sangameshwarekale-arch/ReversePolarityProtection4MOSFET/reports/conduction-calculations.csv

case | front_count | downstream_count | front_current_each_A | downstream_current_each_A | total_R_milliohm | drop_mV | MOSFET_loss_W | front_loss_each_W | downstream_loss_each_W | conditions
25 C specified resistance | 2 | 4 | 22.5 | 11.25 | 1.2 | 53.99999999999999 | 2.4299999999999997 | 0.6074999999999999 | 0.30374999999999996 | Front at 25 C / 10 V gate; downstream at 25 C / 4.5 V gate
25 C specified resistance | 2 | 2 | 22.5 | 22.5 | 1.8 | 81.0 | 3.645 | 0.6074999999999999 | 1.2149999999999999 | Front at 25 C / 10 V gate; downstream at 25 C / 4.5 V gate
25 C specified resistance | 1 | 3 | 45.0 | 15.0 | 2.0 | 90.0 | 4.05 | 2.4299999999999997 | 0.5399999999999999 | Front at 25 C / 10 V gate; downstream at 25 C / 4.5 V gate
25 C specified resistance | 3 | 1 | 15.0 | 45.0 | 2.7999999999999994 | 125.99999999999997 | 5.669999999999999 | 0.26999999999999996 | 4.859999999999999 | Front at 25 C / 10 V gate; downstream at 25 C / 4.5 V gate
105 C / 150 C benchmark | 2 | 4 | 22.5 | 11.25 | 2.3249999999999997 | 104.625 | 4.708125 | 1.11375 | 0.62015625 | Front at 105 C / 10 V gate; downstream at 150 C / 4.5 V gate
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
