sangameshwarekale-arch/ReversePolarityProtection4MOSFET/calculations/placement/candidate-all-top.png

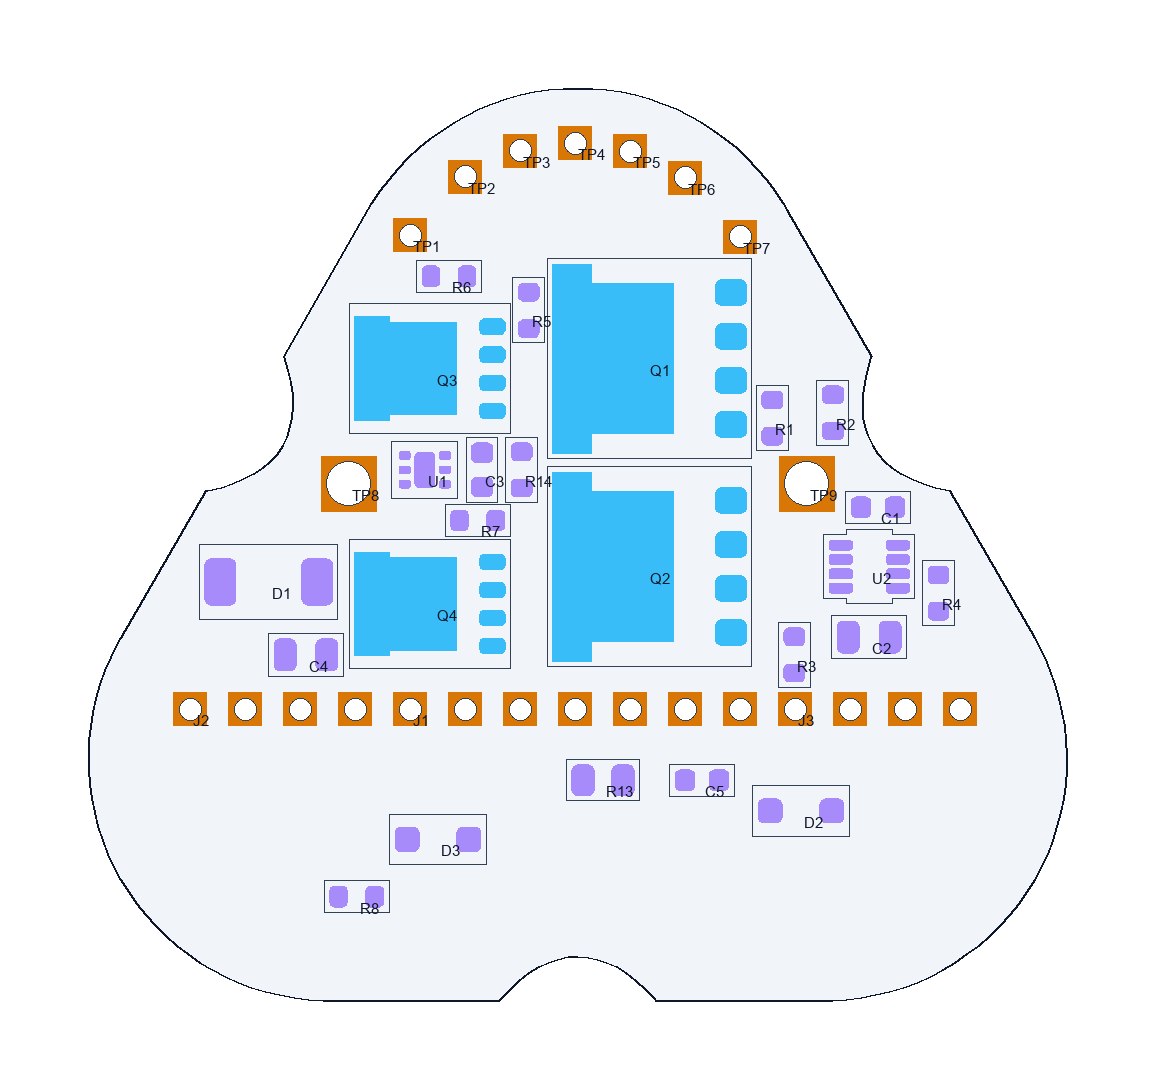
calculations/placement/candidate-all-top.png
