sangameshwarekale-arch/ReversePolarityProtection4MOSFET/redesign45A/routed/images/front.png

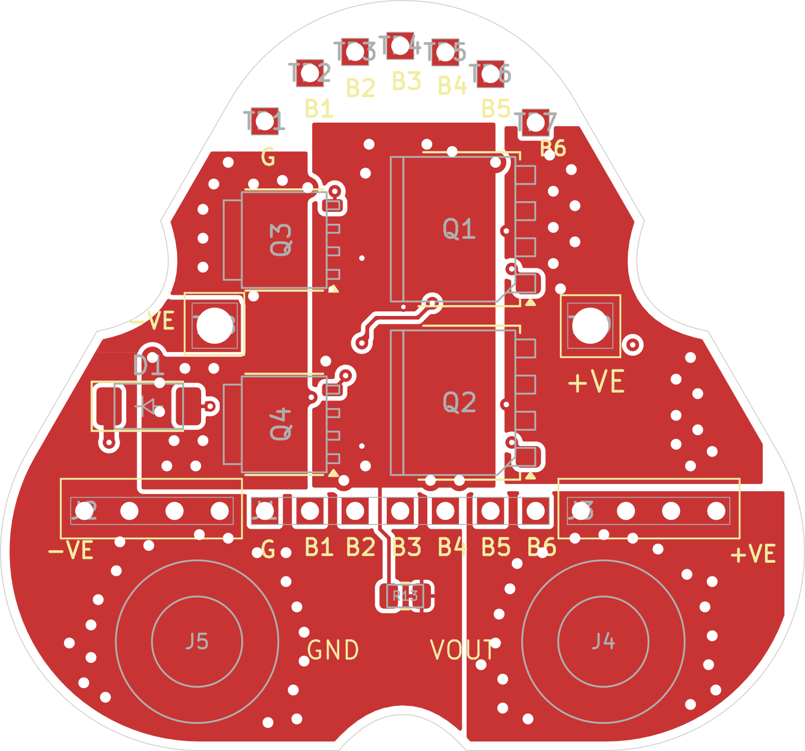
redesign45A/routed/images/front.png
