sangameshwarekale-arch/ReversePolarityProtection4MOSFET/redesign45A/routed/images/inner1.png

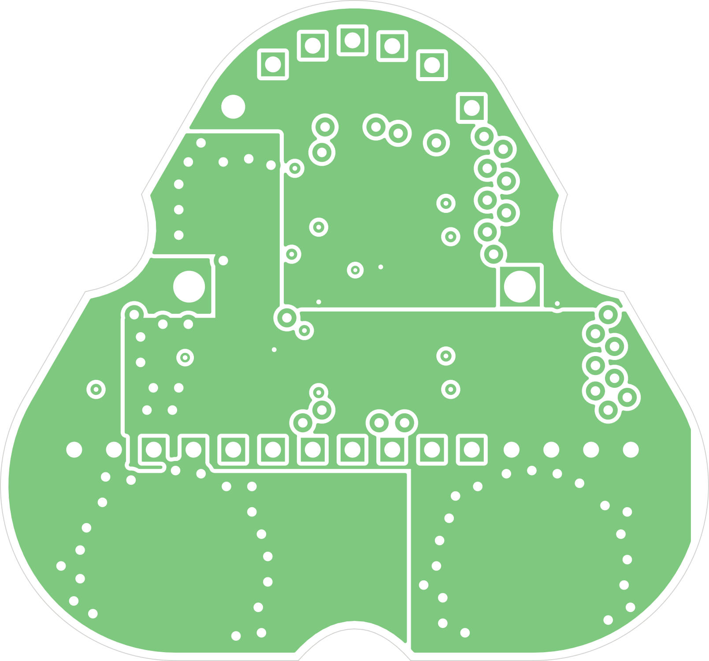
redesign45A/routed/images/inner1.png
