sangameshwarekale-arch/ReversePolarityProtection4MOSFET/redesign45A/routed/images/original-front.png

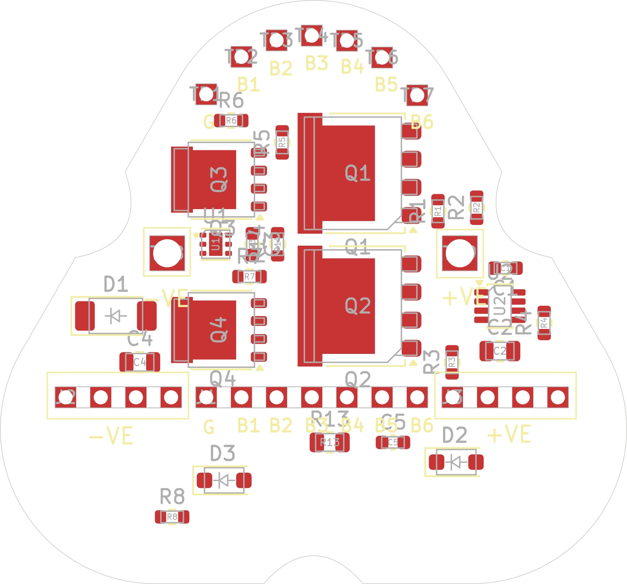
redesign45A/routed/images/original-front.png
