sangameshwarekale-arch/ReversePolarityProtection4MOSFET/redesign45A/routed/images/rear.png

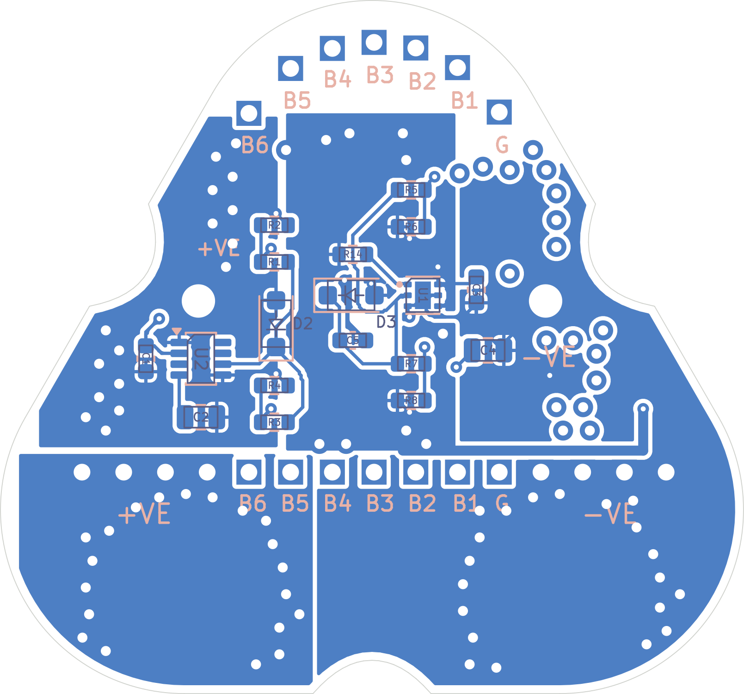
redesign45A/routed/images/rear.png
