sangameshwarekale-arch/ReversePolarityProtection4MOSFET/redesign45A/routed/images/routed-comparison.png

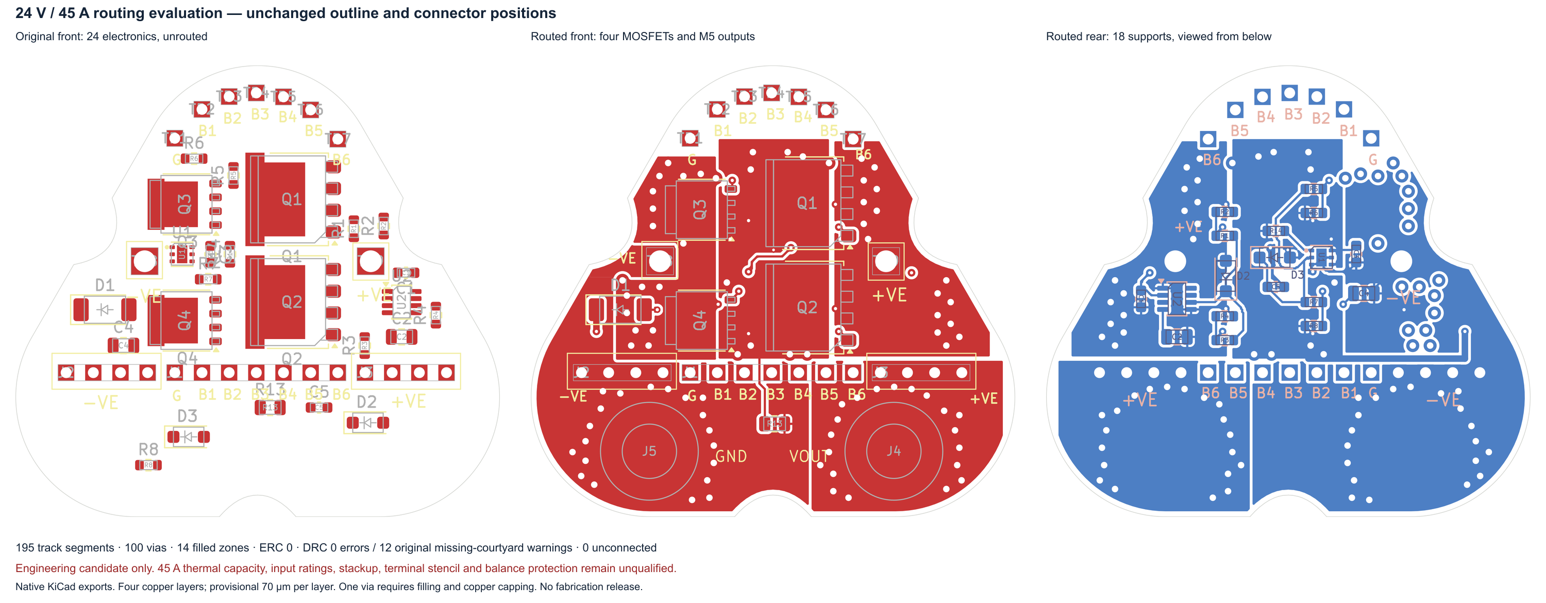
redesign45A/routed/images/routed-comparison.png
