sangameshwarekale-arch/ReversePolarityProtection4MOSFET/redesign45A/routed/images/schematic.png

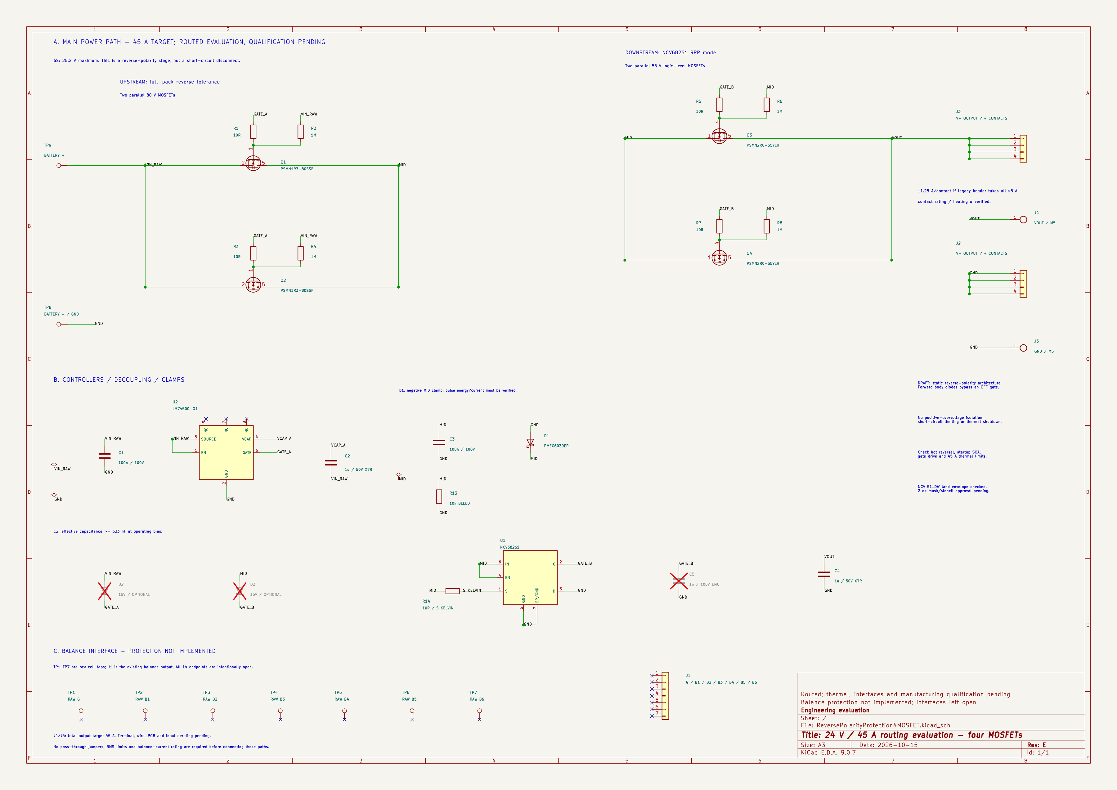
redesign45A/routed/images/schematic.png
