sangameshwarekale-arch/ReversePolarityProtection4MOSFET/BOM.csv

Reference | Quantity | Value | Manufacturer | Manufacturer part number | Footprint | Population | Datasheet | Assembly / qualification note
Q1 | 1 | PSMN1R3-80SSF | Nexperia | PSMN1R3-80SSFJ | Protection:LFPAK88 | Fit | https://assets.nexperia.com/documents/data-sheet/PSMN1R3-80SSF.pdf | Existing selected component; actual operating/thermal conditions require qualification.
R1 | 1 | 10R | Yageo | RC0603FR-0710RL | Resistor_SMD:R_0603_1608Metric | Fit | ~ | Existing selected component; actual operating/thermal conditions require qualification.
R2 | 1 | 1M | Yageo | RC0603FR-071ML | Resistor_SMD:R_0603_1608Metric | Fit | ~ | Existing selected component; actual operating/thermal conditions require qualification.
Q2 | 1 | PSMN1R3-80SSF | Nexperia | PSMN1R3-80SSFJ | Protection:LFPAK88 | Fit | https://assets.nexperia.com/documents/data-sheet/PSMN1R3-80SSF.pdf | Existing selected component; actual operating/thermal conditions require qualification.
R3 | 1 | 10R | Yageo | RC0603FR-0710RL | Resistor_SMD:R_0603_1608Metric | Fit | ~ | Existing selected component; actual operating/thermal conditions require qualification.
R4 | 1 | 1M | Yageo | RC0603FR-071ML | Resistor_SMD:R_0603_1608Metric | Fit | ~ | Existing selected component; actual operating/thermal conditions require qualification.
Q3 | 1 | PSMN2R0-55YLH | Nexperia | PSMN2R0-55YLHX | Protection:LFPAK56E | Fit | https://assets.nexperia.com/documents/data-sheet/PSMN2R0-55YLH.pdf | Existing selected component; actual operating/thermal conditions require qualification.
R5 | 1 | 10R | Yageo | RC0603FR-0710RL | Resistor_SMD:R_0603_1608Metric | Fit | ~ | Existing selected component; actual operating/thermal conditions require qualification.
R6 | 1 | 1M | Yageo | RC0603FR-071ML | Resistor_SMD:R_0603_1608Metric | Fit | ~ | Existing selected component; actual operating/thermal conditions require qualification.
Q4 | 1 | PSMN2R0-55YLH | Nexperia | PSMN2R0-55YLHX | Protection:LFPAK56E | Fit | https://assets.nexperia.com/documents/data-sheet/PSMN2R0-55YLH.pdf | Existing selected component; actual operating/thermal conditions require qualification.
R7 | 1 | 10R | Yageo | RC0603FR-0710RL | Resistor_SMD:R_0603_1608Metric | Fit | ~ | Existing selected component; actual operating/thermal conditions require qualification.
R8 | 1 | 1M | Yageo | RC0603FR-071ML | Resistor_SMD:R_0603_1608Metric | Fit | ~ | Existing selected component; actual operating/thermal conditions require qualification.
TP9 | 1 | BATTERY + | Unknown original termination | EXISTING TERMINATION - RATING UNKNOWN | OriginalMechanical:WireSolderPad_VPlus_DXF | Fit | ~ | Original model/current rating/body envelope unknown; preserved geometry. Not qualified for45A.
TP8 | 1 | BATTERY - / GND | Unknown original termination | EXISTING TERMINATION - RATING UNKNOWN | OriginalMechanical:WireSolderPad_VMinus_DXF | Fit | ~ | Original model/current rating/body envelope unknown; preserved geometry. Not qualified for45A.
J3 | 1 | V+ OUTPUT / 4 CONTACTS | Unknown original termination | EXISTING CONNECTOR - RATING UNKNOWN | OriginalMechanical:Connector_1x04_P2.50mm_VPlus_DXF | Fit | ~ | Original model/current rating/body envelope unknown; preserved geometry. Not qualified for45A.
J2 | 1 | V- OUTPUT / 4 CONTACTS | Unknown original termination | EXISTING CONNECTOR - RATING UNKNOWN | OriginalMechanical:Connector_1x04_P2.50mm_VMinus_DXF | Fit | ~ | Original model/current rating/body envelope unknown; preserved geometry. Not qualified for45A.
U2 | 1 | LM74500-Q1 | Texas Instruments | LM74500QDDFRQ1 | Protection:TI_DDF8 | Fit | https://www.ti.com/lit/ds/symlink/lm74500-q1.pdf | Existing selected component; actual operating/thermal conditions require qualification.
U1 | 1 | NCV68261 | onsemi | NCV68261MTWAITBG | Protection:NCV68261_WDFNW6 | Fit | https://www.onsemi.com/pdf/datasheet/ncv68261-d.pdf | Existing selected component; actual operating/thermal conditions require qualification.
R14 | 1 | 10R / S KELVIN | Yageo | RC0603FR-0710RL | Resistor_SMD:R_0603_1608Metric | Fit | ~ | Existing selected component; actual operating/thermal conditions require qualification.
C1 | 1 | 100n / 100V | Murata | GRM188R72A104KA35D | Capacitor_SMD:C_0603_1608Metric | Fit | https://search.murata.co.jp/Ceramy/image/img/A01X/G101/ENG/GRM188R72A104KA35-01A.pdf | Existing selected component; actual operating/thermal conditions require qualification.
C2 | 1 | 1u / 50V X7R | Murata | GCM21BR71H105KA03L | Capacitor_SMD:C_0805_2012Metric | Fit | https://search.murata.co.jp/Ceramy/image/img/A01X/G101/ENG/GCM21BR71H105KA03-01A.pdf | Existing selected component; actual operating/thermal conditions require qualification.
C3 | 1 | 100n / 100V | Murata | GRM188R72A104KA35D | Capacitor_SMD:C_0603_1608Metric | Fit | ~ | Existing selected component; actual operating/thermal conditions require qualification.
C4 | 1 | 1u / 50V X7R | Murata | GCM21BR71H105KA03L | Capacitor_SMD:C_0805_2012Metric | Fit | ~ | Existing selected component; actual operating/thermal conditions require qualification.
C5 | 1 | 1n / 100V EMC | Murata | GCM1885C2A102JA16D | Capacitor_SMD:C_0603_1608Metric | DNP | ~ | DNP retained; do not credit as fitted protection. Verify ratings before population.
R13 | 1 | 10k BLEED | Yageo | RC0805FR-0710KL | Resistor_SMD:R_0805_2012Metric | Fit | ~ | Existing selected component; actual operating/thermal conditions require qualification.
D1 | 1 | PMEG6030EP | Nexperia | PMEG6030EP,115 | Protection:SOD128 | Fit | https://assets.nexperia.com/documents/data-sheet/PMEG6030EP.pdf | Existing selected component; actual operating/thermal conditions require qualification.
D2 | 1 | 15V / OPTIONAL | Nexperia | BZT52H-C15,115 | Protection:SOD123F | DNP | https://assets.nexperia.com/documents/data-sheet/BZT52H_SER.pdf | DNP retained; do not credit as fitted protection. Verify ratings before population.
D3 | 1 | 15V / OPTIONAL | Nexperia | BZT52H-C15,115 | Protection:SOD123F | DNP | https://assets.nexperia.com/documents/data-sheet/BZT52H_SER.pdf | DNP retained; do not credit as fitted protection. Verify ratings before population. Adjacent MID tie via X126.9,Y89.0 requires filling and copper capping both sides.
TP1 | 1 | RAW G | Unknown original termination | EXISTING TAP | OriginalMechanical:BatteryTap_G_DXF | Fit | ~ | Original model/current rating/body envelope unknown; preserved geometry. Not qualified for45A.
TP2 | 1 | RAW B1 | Unknown original termination | EXISTING TAP | OriginalMechanical:BatteryTap_B1_DXF | Fit | ~ | Original model/current rating/body envelope unknown; preserved geometry. Not qualified for45A.
TP3 | 1 | RAW B2 | Unknown original termination | EXISTING TAP | OriginalMechanical:BatteryTap_B2_DXF | Fit | ~ | Original model/current rating/body envelope unknown; preserved geometry. Not qualified for45A.
TP4 | 1 | RAW B3 | Unknown original termination | EXISTING TAP | OriginalMechanical:BatteryTap_B3_DXF | Fit | ~ | Original model/current rating/body envelope unknown; preserved geometry. Not qualified for45A.
TP5 | 1 | RAW B4 | Unknown original termination | EXISTING TAP | OriginalMechanical:BatteryTap_B4_DXF | Fit | ~ | Original model/current rating/body envelope unknown; preserved geometry. Not qualified for45A.
TP6 | 1 | RAW B5 | Unknown original termination | EXISTING TAP | OriginalMechanical:BatteryTap_B5_DXF | Fit | ~ | Original model/current rating/body envelope unknown; preserved geometry. Not qualified for45A.
TP7 | 1 | RAW B6 | Unknown original termination | EXISTING TAP | OriginalMechanical:BatteryTap_B6_DXF | Fit | ~ | Original model/current rating/body envelope unknown; preserved geometry. Not qualified for45A.
J1 | 1 | G / B1 / B2 / B3 / B4 / B5 / B6 | Unknown original termination | EXISTING CONNECTOR - RATING UNKNOWN | OriginalMechanical:Header_1x07_P2.50mm_DXF | Fit | ~ | Original model/current rating/body envelope unknown; preserved geometry. Not qualified for45A.
J4 | 1 | VOUT / M5 | Wurth Elektronik | 7466205R | Protection:Wuerth_7466205R_M5_SMT | Candidate fit; thermal/mechanical/stencil qualification pending | https://www.we-online.com/components/products/datasheet/7466205R.pdf | Candidate70A catalogue terminal; total board target45A, actual derating unverified. No paste apertures: stencil hold; lug/hardware/support not selected.
J5 | 1 | GND / M5 | Wurth Elektronik | 7466205R | Protection:Wuerth_7466205R_M5_SMT | Candidate fit; thermal/mechanical/stencil qualification pending | https://www.we-online.com/components/products/datasheet/7466205R.pdf | Candidate70A catalogue terminal; total board target45A, actual derating unverified. No paste apertures: stencil hold; lug/hardware/support not selected.
