sangameshwarekale-arch/ReversePolarityProtection4MOSFET/reports/schematic-preliminary-60A.pdf

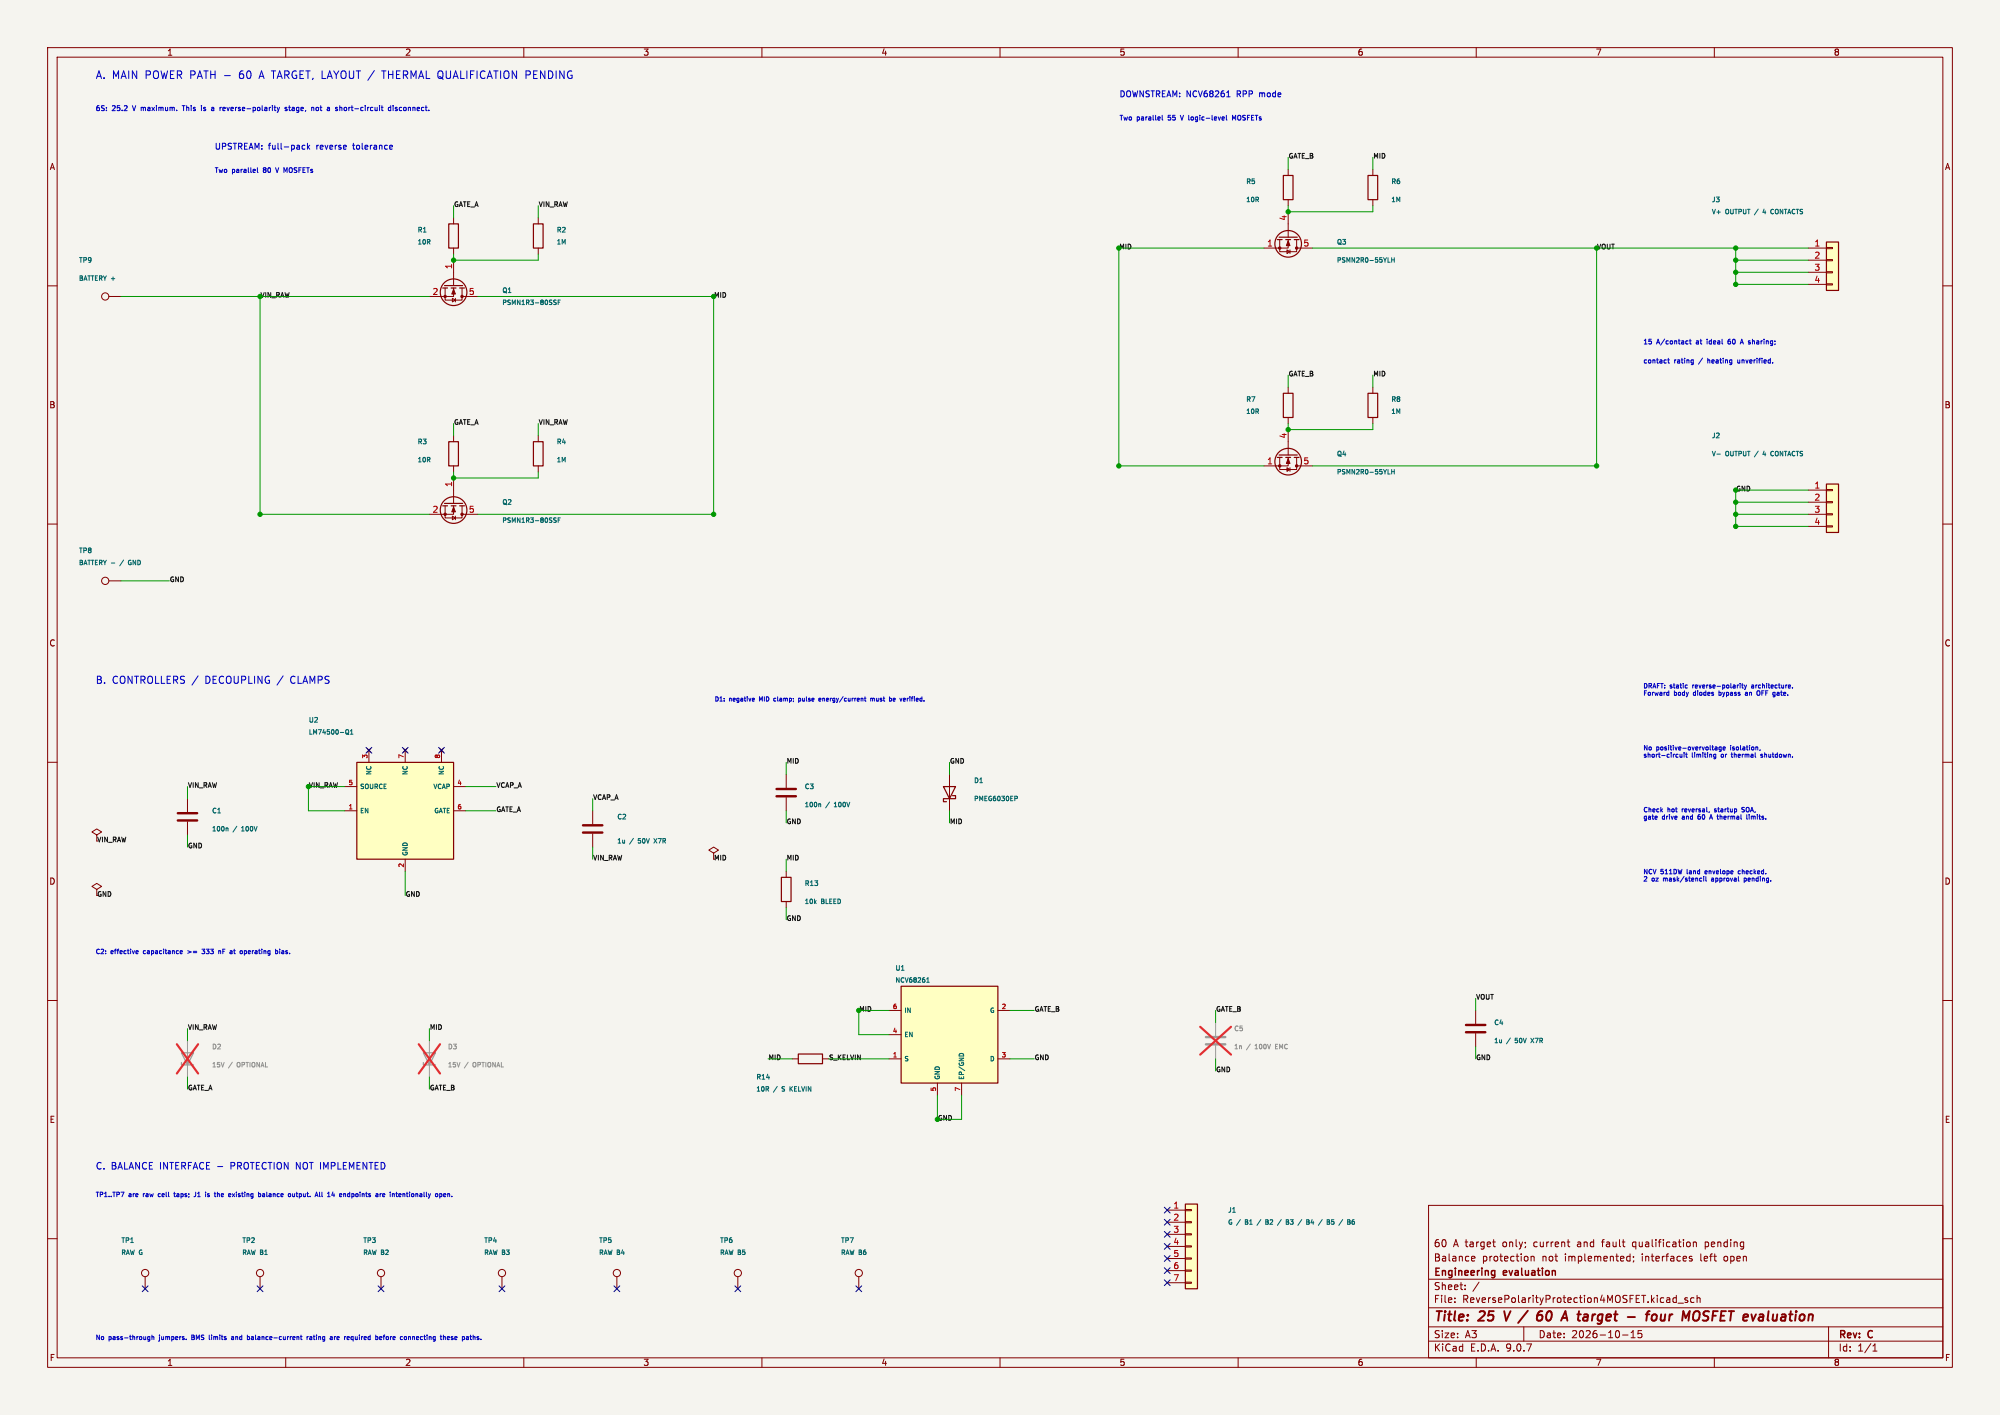
[picture p8: page 1]

A. MAIN POWER PATH - 60 A TARGET, LAYOUT / THERMAL QUALIFICATION PENDING

Id: 1/1 Title: 25 V / 60 A target - four MOSFET evaluation
