sangameshwarekale-arch/ReversePolarityProtection4MOSFET/(list of files, drawings)

Other design files:
reports/schematic-60A-status-update.json
