sangameshwarekale-arch/ReversePolarityProtection4MOSFET/ReversePolarityProtection4MOSFET.kicad_pcb

## KiCad design ReversePolarityProtection4MOSFET.kicad_pcb (2026-10-15)

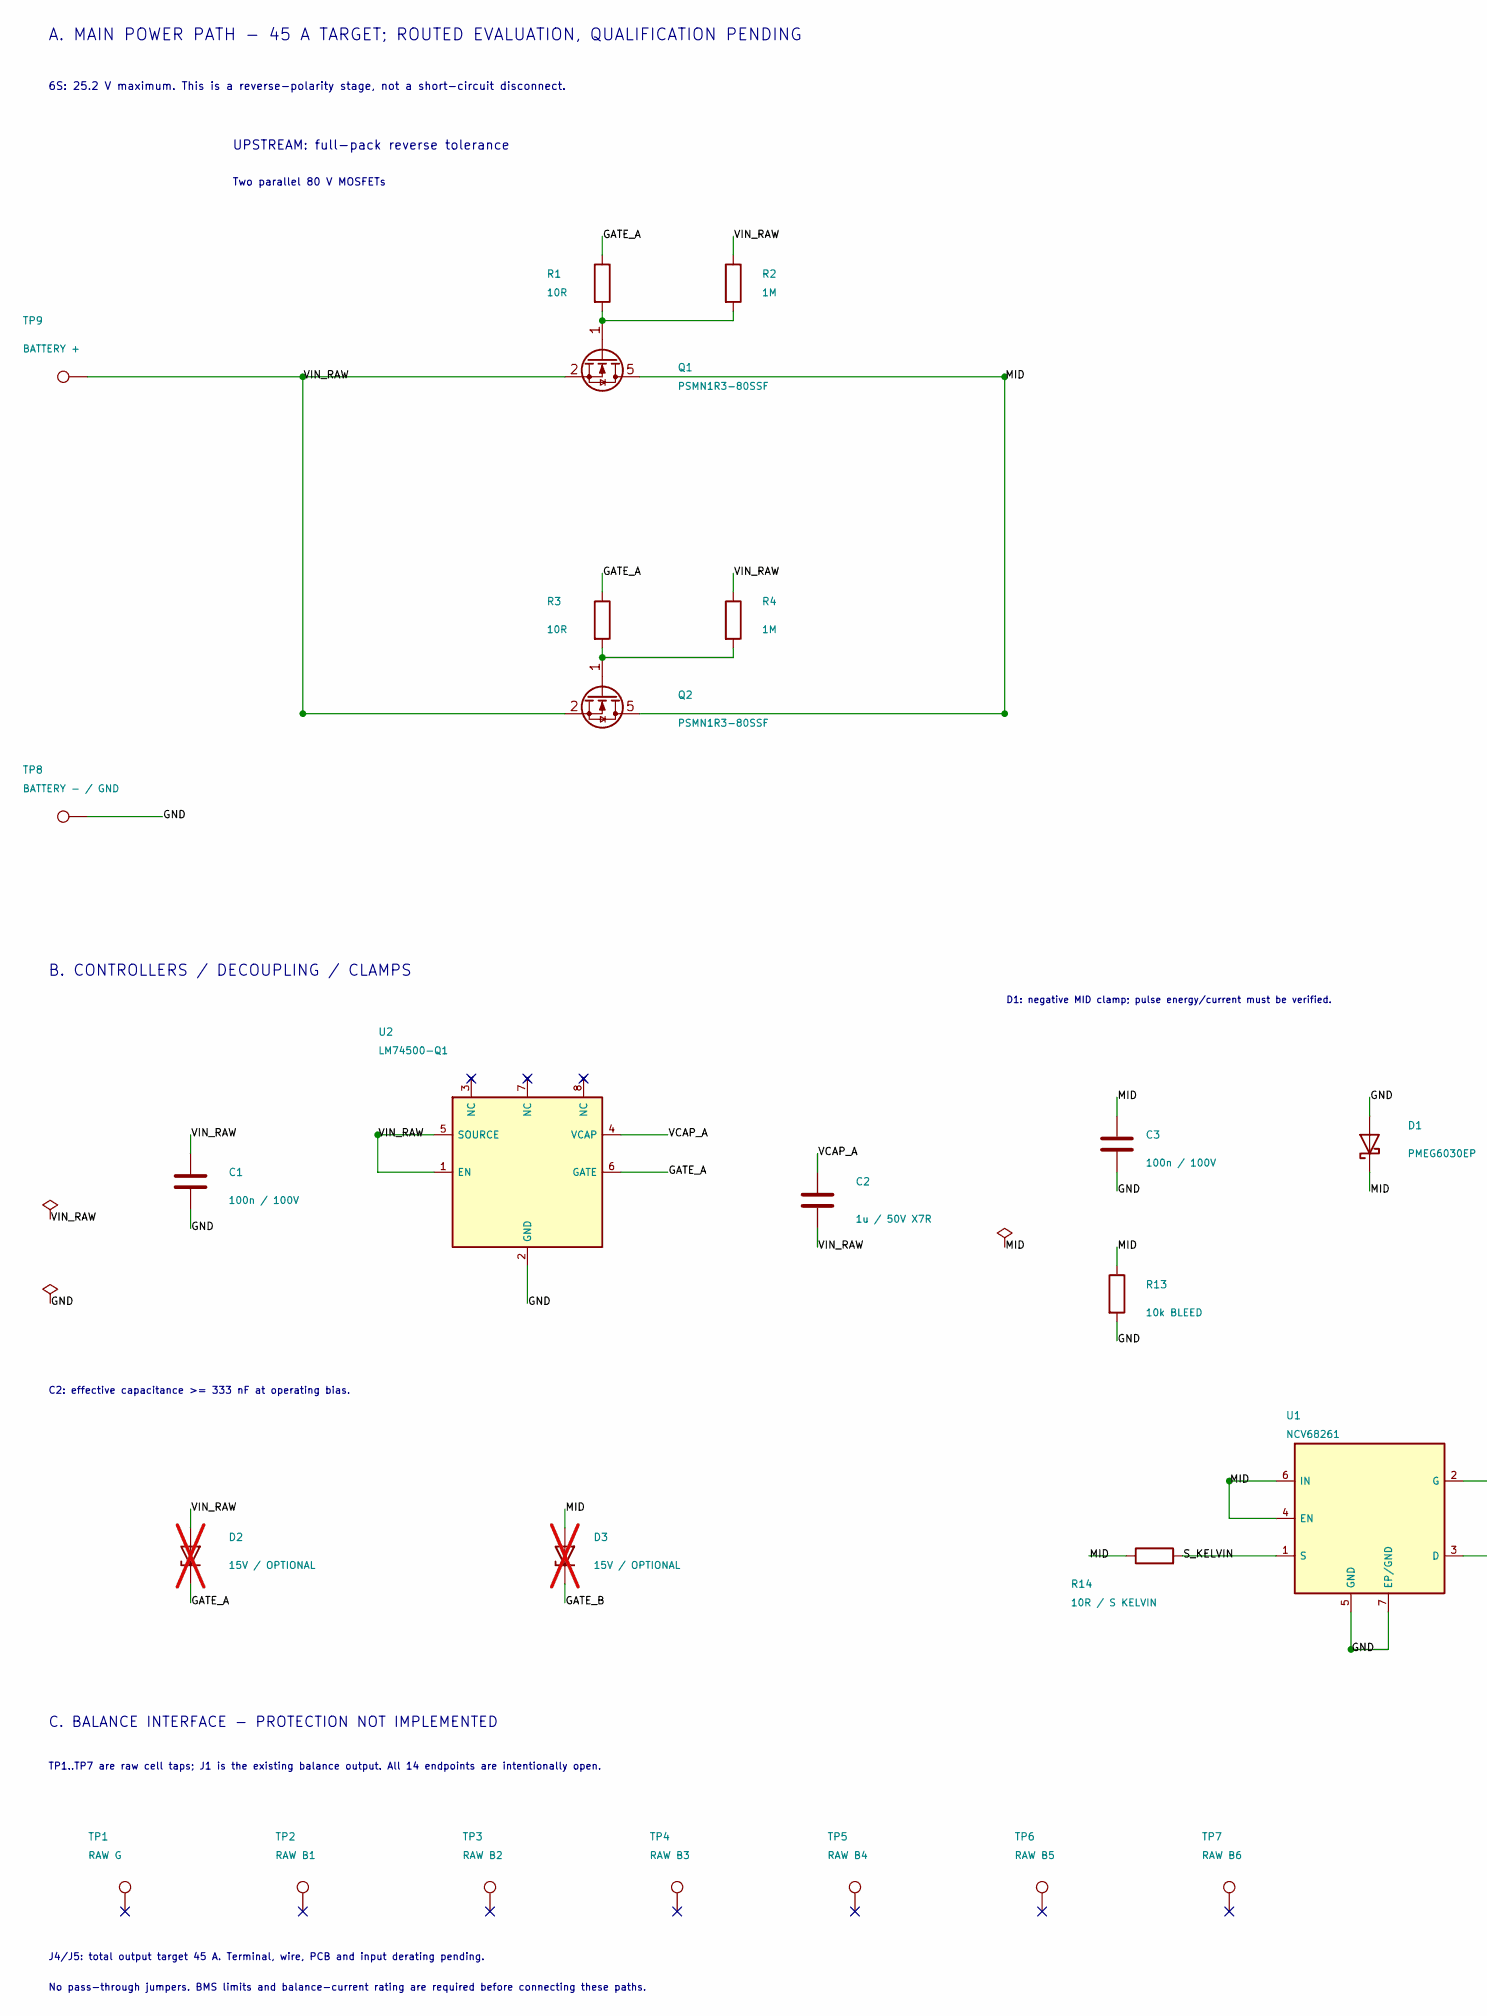
[picture p9: schematic ReversePolarityProtection4MOSFET.kicad_sch, 24 V / 45 A routing evaluation - four MOSFETs, part in row 1, column 1]

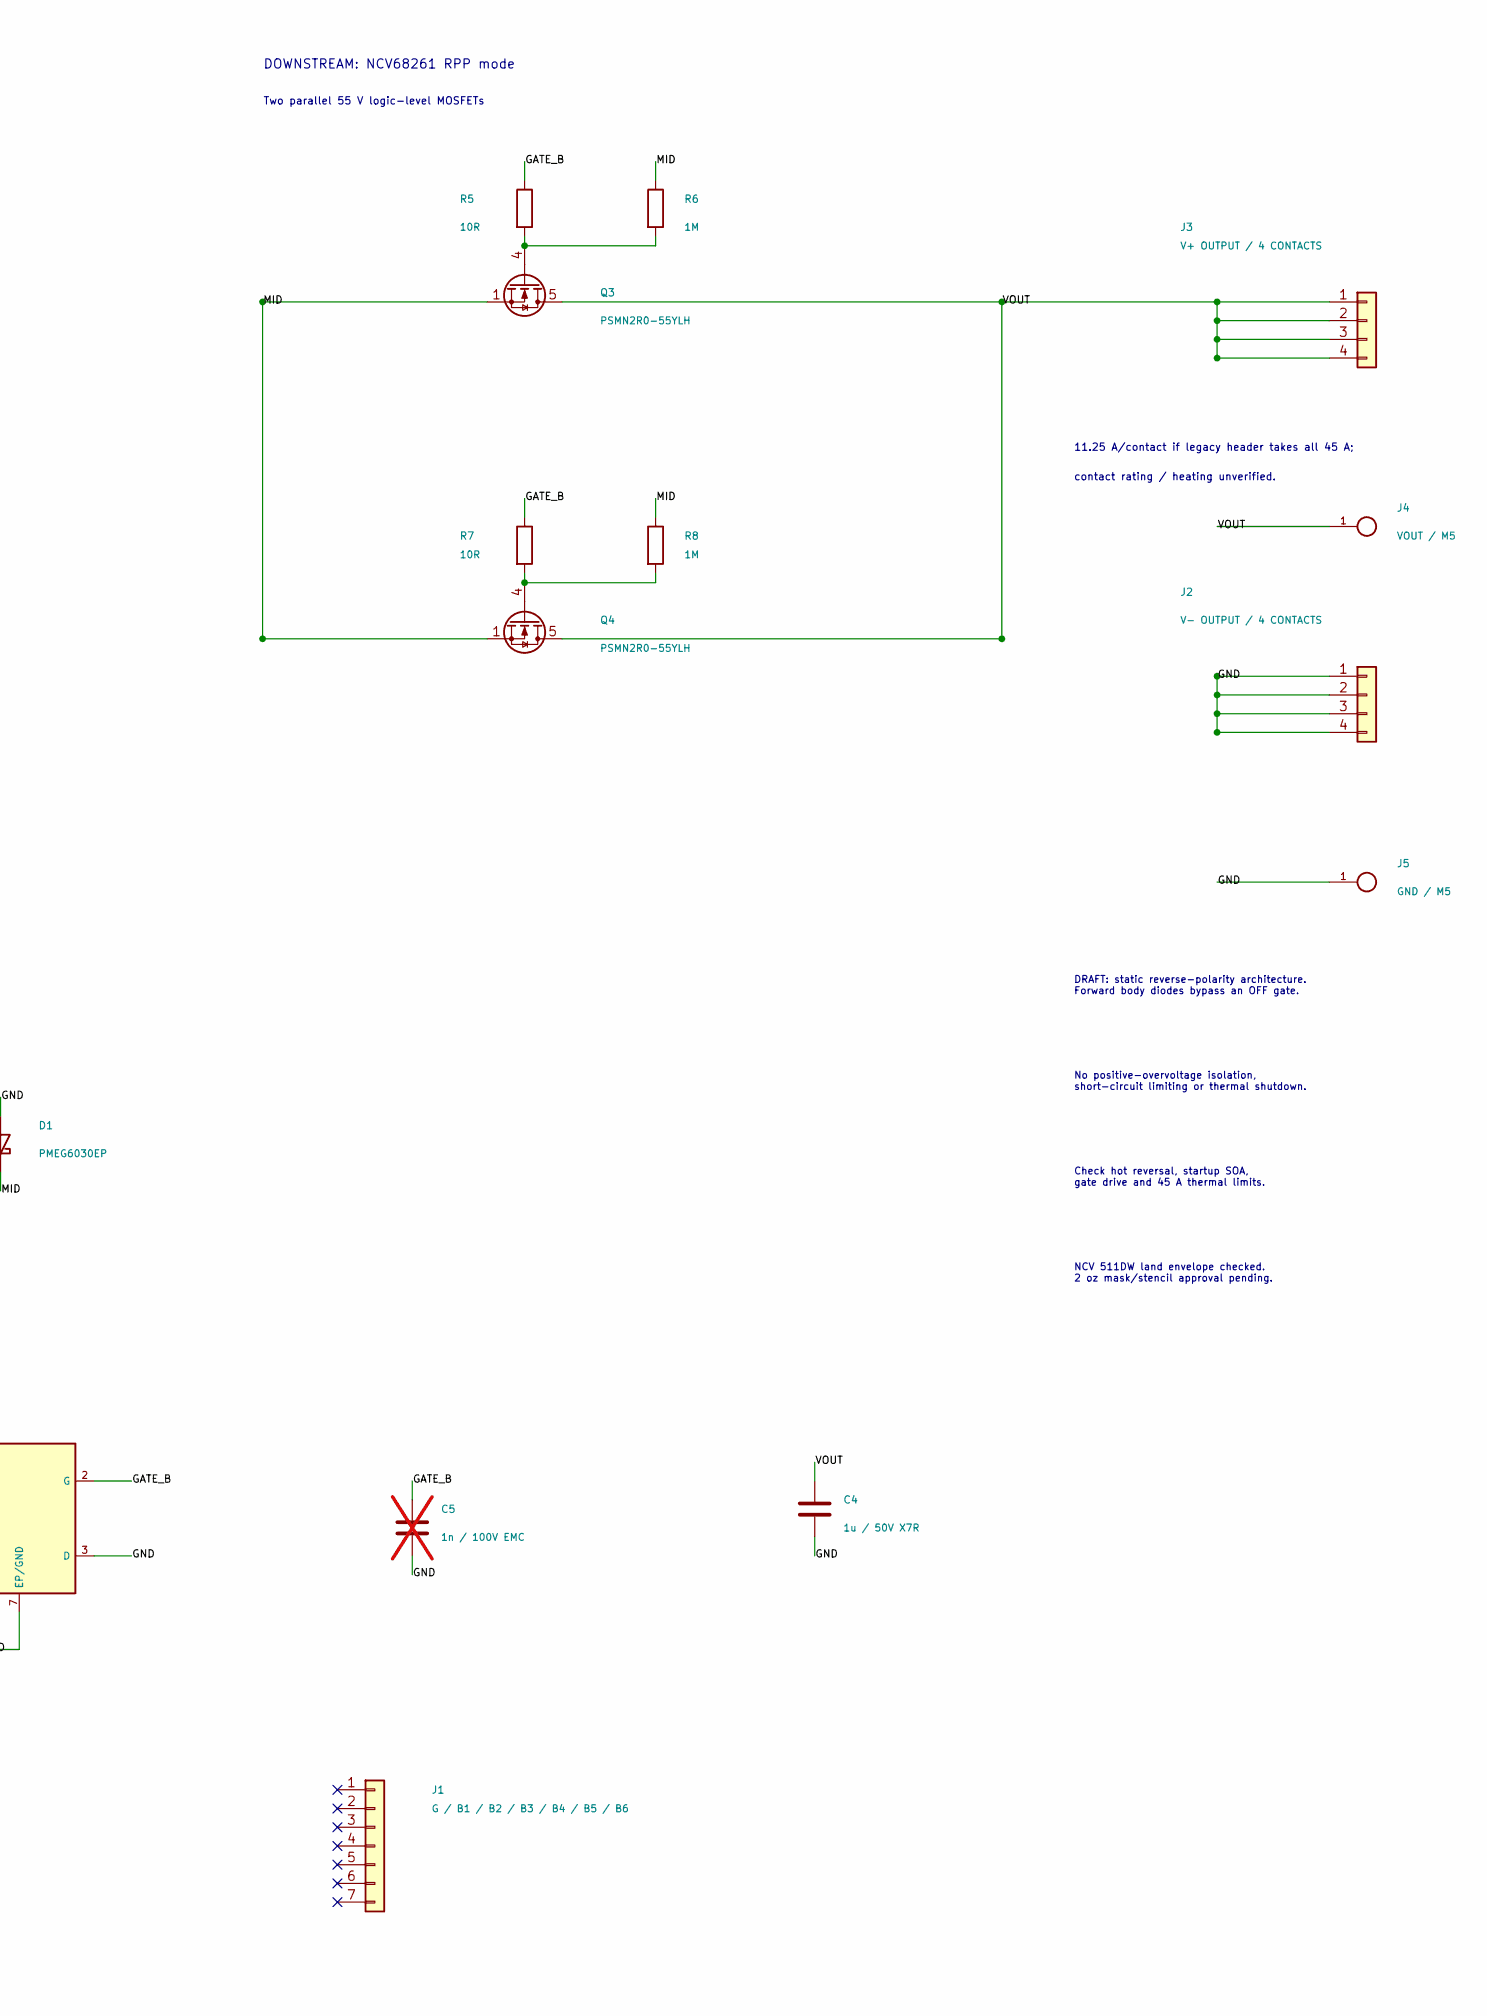
[picture p10: schematic ReversePolarityProtection4MOSFET.kicad_sch, 24 V / 45 A routing evaluation - four MOSFETs, part in row 1, column 2]

Parts:
C1, C3: 100n / 100V; C_0603_1608Metric; MPN GRM188R72A104KA35D
C2, C4: 1u / 50V X7R; C_0805_2012Metric; MPN GCM21BR71H105KA03L
C5: 1n / 100V EMC; C_0603_1608Metric; MPN GCM1885C2A102JA16D; not fitted
D1: PMEG6030EP; SOD128; MPN PMEG6030EP,115
D2, D3: 15V / OPTIONAL; SOD123F; MPN BZT52H-C15,115; not fitted
J1: G / B1 / B2 / B3 / B4 / B5 / B6; Header_1x07_P2.50mm_DXF; MPN EXISTING CONNECTOR - RATING UNKNOWN
J2: V- OUTPUT / 4 CONTACTS; Connector_1x04_P2.50mm_VMinus_DXF; MPN EXISTING CONNECTOR - RATING UNKNOWN
J3: V+ OUTPUT / 4 CONTACTS; Connector_1x04_P2.50mm_VPlus_DXF; MPN EXISTING CONNECTOR - RATING UNKNOWN
J4: VOUT / M5; Wuerth_7466205R_M5_SMT; MPN 7466205R
J5: GND / M5; Wuerth_7466205R_M5_SMT; MPN 7466205R
Q1, Q2: PSMN1R3-80SSF; LFPAK88; MPN PSMN1R3-80SSFJ
Q3, Q4: PSMN2R0-55YLH; LFPAK56E; MPN PSMN2R0-55YLHX
R1, R3, R5, R7: 10R; R_0603_1608Metric; MPN RC0603FR-0710RL
R2, R4, R6, R8: 1M; R_0603_1608Metric; MPN RC0603FR-071ML
R13: 10k BLEED; R_0805_2012Metric; MPN RC0805FR-0710KL
R14: 10R / S KELVIN; R_0603_1608Metric; MPN RC0603FR-0710RL
TP1: RAW G; BatteryTap_G_DXF; MPN EXISTING TAP
TP2: RAW B1; BatteryTap_B1_DXF; MPN EXISTING TAP
TP3: RAW B2; BatteryTap_B2_DXF; MPN EXISTING TAP
TP4: RAW B3; BatteryTap_B3_DXF; MPN EXISTING TAP
TP5: RAW B4; BatteryTap_B4_DXF; MPN EXISTING TAP
TP6: RAW B5; BatteryTap_B5_DXF; MPN EXISTING TAP
TP7: RAW B6; BatteryTap_B6_DXF; MPN EXISTING TAP
TP8: BATTERY - / GND; WireSolderPad_VMinus_DXF; MPN EXISTING TERMINATION - RATING UNKNOWN
TP9: BATTERY +; WireSolderPad_VPlus_DXF; MPN EXISTING TERMINATION - RATING UNKNOWN
U1: NCV68261; NCV68261_WDFNW6; MPN NCV68261MTWAITBG
U2: LM74500-Q1; TI_DDF8; MPN LM74500QDDFRQ1

Connections:
/GATE_A: D2.1 (K), R1.1, R3.1, U2.6 (GATE)
/GATE_B: C5.1, D3.1 (K), R5.1, R7.1, U1.2 (G)
/GND: C1.2, C3.2, C4.2, C5.2, D1.2 (A), J2.1, J2.2, J2.3, J2.4, J5.1, R13.2, TP8.1, U1.3 (D), U1.5 (GND), U1.7 (EP/GND), U2.2 (GND)
/MID: C3.1, D1.1 (K), D3.2 (A), Q1.5 (D), Q2.5 (D), Q3.1 (S), Q3.2 (S), Q3.3 (S), Q4.1 (S), Q4.2 (S), Q4.3 (S), R6.1, R8.1, R13.1, R14.1, U1.4 (EN), U1.6 (IN)
/S_KELVIN: R14.2, U1.1 (S)
/VCAP_A: C2.1, U2.4 (VCAP)
/VIN_RAW: C1.1, C2.2, D2.2 (A), Q1.2 (S), Q1.3 (S), Q1.4 (S), Q2.2 (S), Q2.3 (S), Q2.4 (S), R2.1, R4.1, TP9.1, U2.1 (EN), U2.5 (SOURCE)
/VOUT: C4.1, J3.1, J3.2, J3.3, J3.4, J4.1, Q3.5 (D), Q4.5 (D)
unnamed: Q1.1 (G), R1.2, R2.2
unnamed: Q2.1 (G), R3.2, R4.2
unnamed: Q3.4 (G), R5.2, R6.2
unnamed: Q4.4 (G), R7.2, R8.2

Notes on the sheet:
A. MAIN POWER PATH - 45 A TARGET; ROUTED EVALUATION, QUALIFICATION PENDING
6S: 25.2 V maximum. This is a reverse-polarity stage, not a short-circuit disconnect.
UPSTREAM: full-pack reverse tolerance
DOWNSTREAM: NCV68261 RPP mode
Two parallel 80 V MOSFETs
Two parallel 55 V logic-level MOSFETs
11.25 A/contact if legacy header takes all 45 A;
contact rating / heating unverified.
B. CONTROLLERS / DECOUPLING / CLAMPS
C2: effective capacitance >= 333 nF at operating bias.
D1: negative MID clamp; pulse energy/current must be verified.
C. BALANCE INTERFACE - PROTECTION NOT IMPLEMENTED
TP1..TP7 are raw cell taps; J1 is the existing balance output. All 14 endpoints are intentionally open.
No pass-through jumpers. BMS limits and balance-current rating are required before connecting these paths.
DRAFT: static reverse-polarity architecture. Forward body diodes bypass an OFF gate.
No positive-overvoltage isolation, short-circuit limiting or thermal shutdown.
Check hot reversal, startup SOA, gate drive and 45 A thermal limits.
NCV 511DW land envelope checked. 2 oz mask/stencil approval pending.
J4/J5: total output target 45 A. Terminal, wire, PCB and input derating pending.

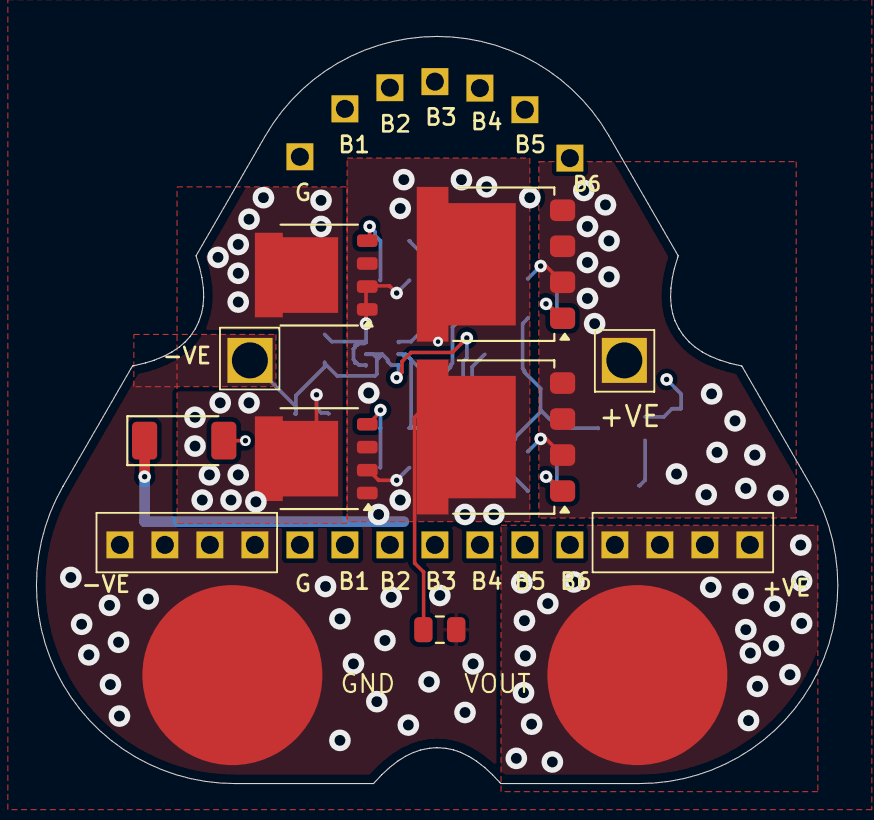
[picture p11: board ReversePolarityProtection4MOSFET.kicad_pcb from above]

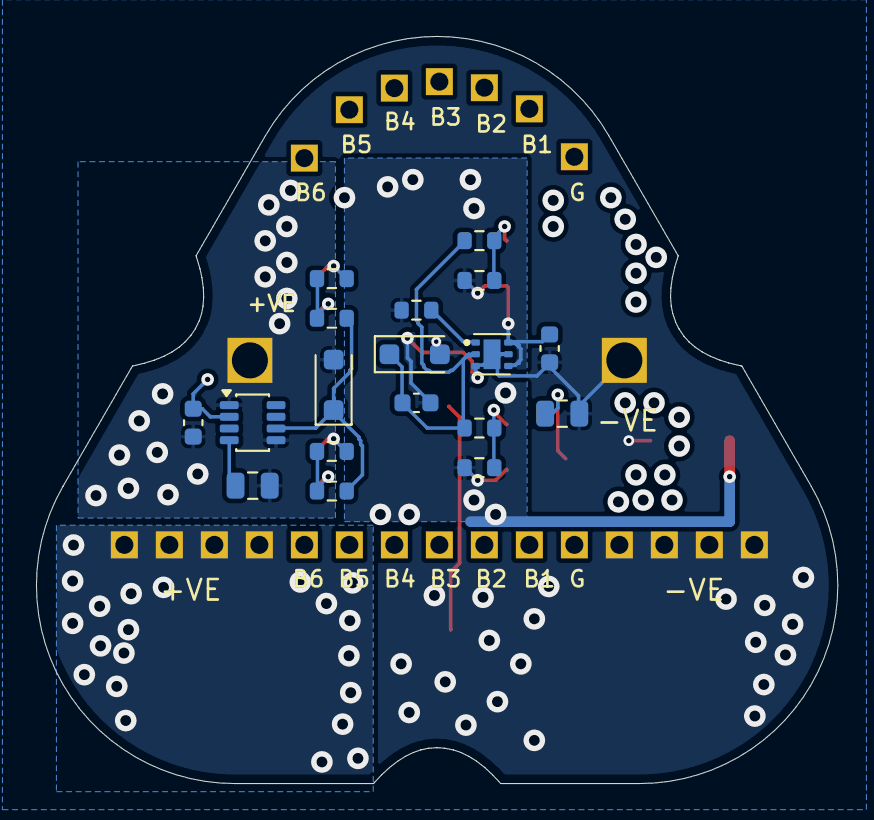
[picture p12: board ReversePolarityProtection4MOSFET.kicad_pcb from below]

Board: 4 copper layers, 44.5 x 41.5 mm, 38 parts (18 on the bottom side), 12 nets.
